davixcky/entrenador-atmega328p/capturas/05-app-diagrama-codigo.png

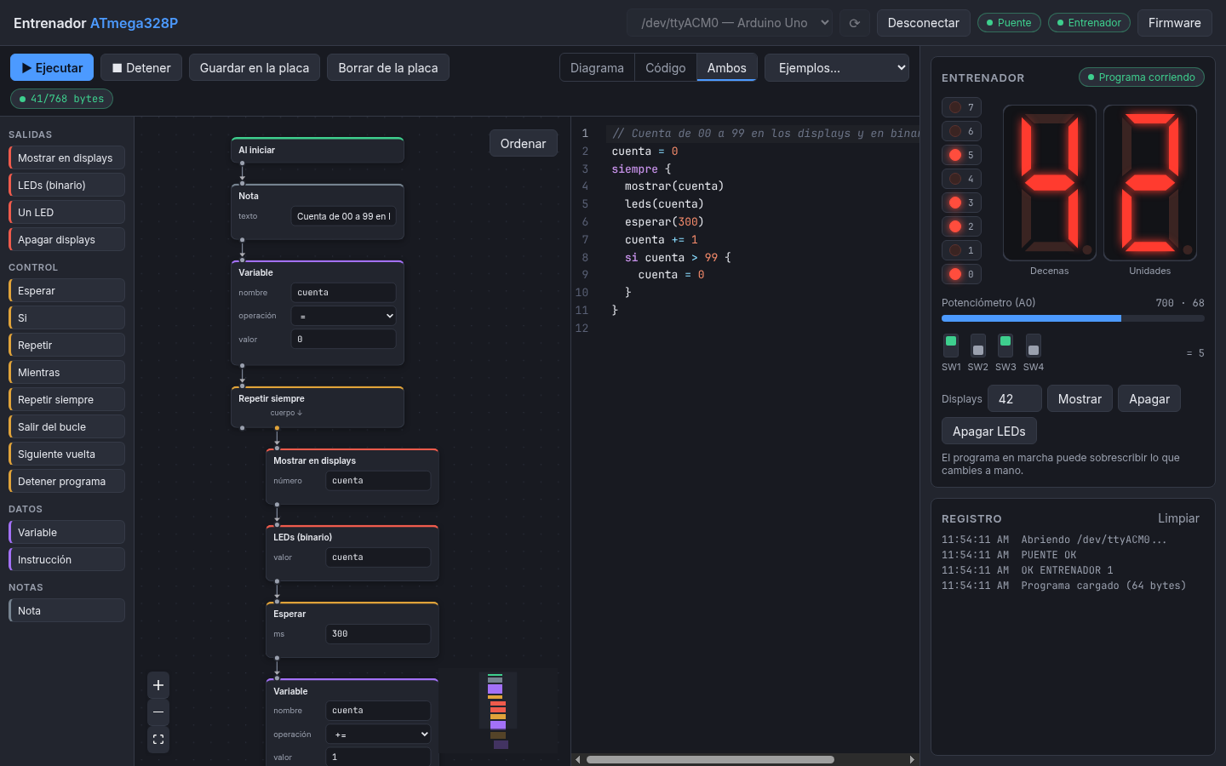
capturas/05-app-diagrama-codigo.png
