davixcky/entrenador-atmega328p/capturas/06-app-monitor-placa.png

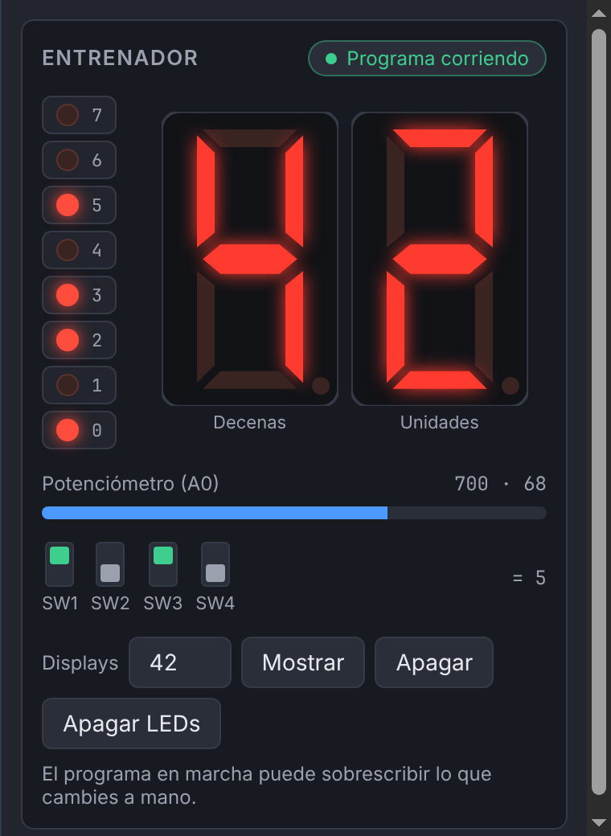
capturas/06-app-monitor-placa.png
