davixcky/entrenador-atmega328p/kicad/fabricacion/render-abajo.png

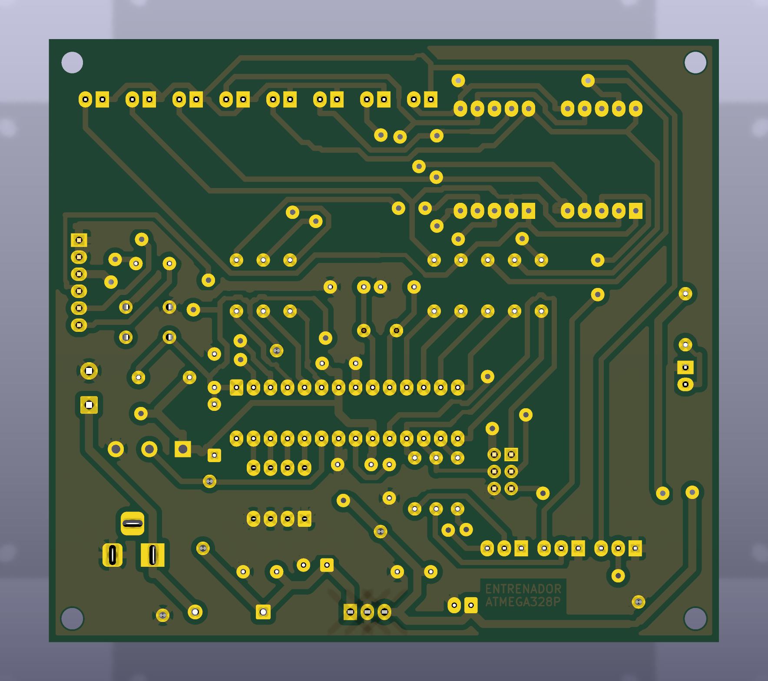
kicad/fabricacion/render-abajo.png
