davixcky/entrenador-atmega328p/kicad/esquematico.pdf

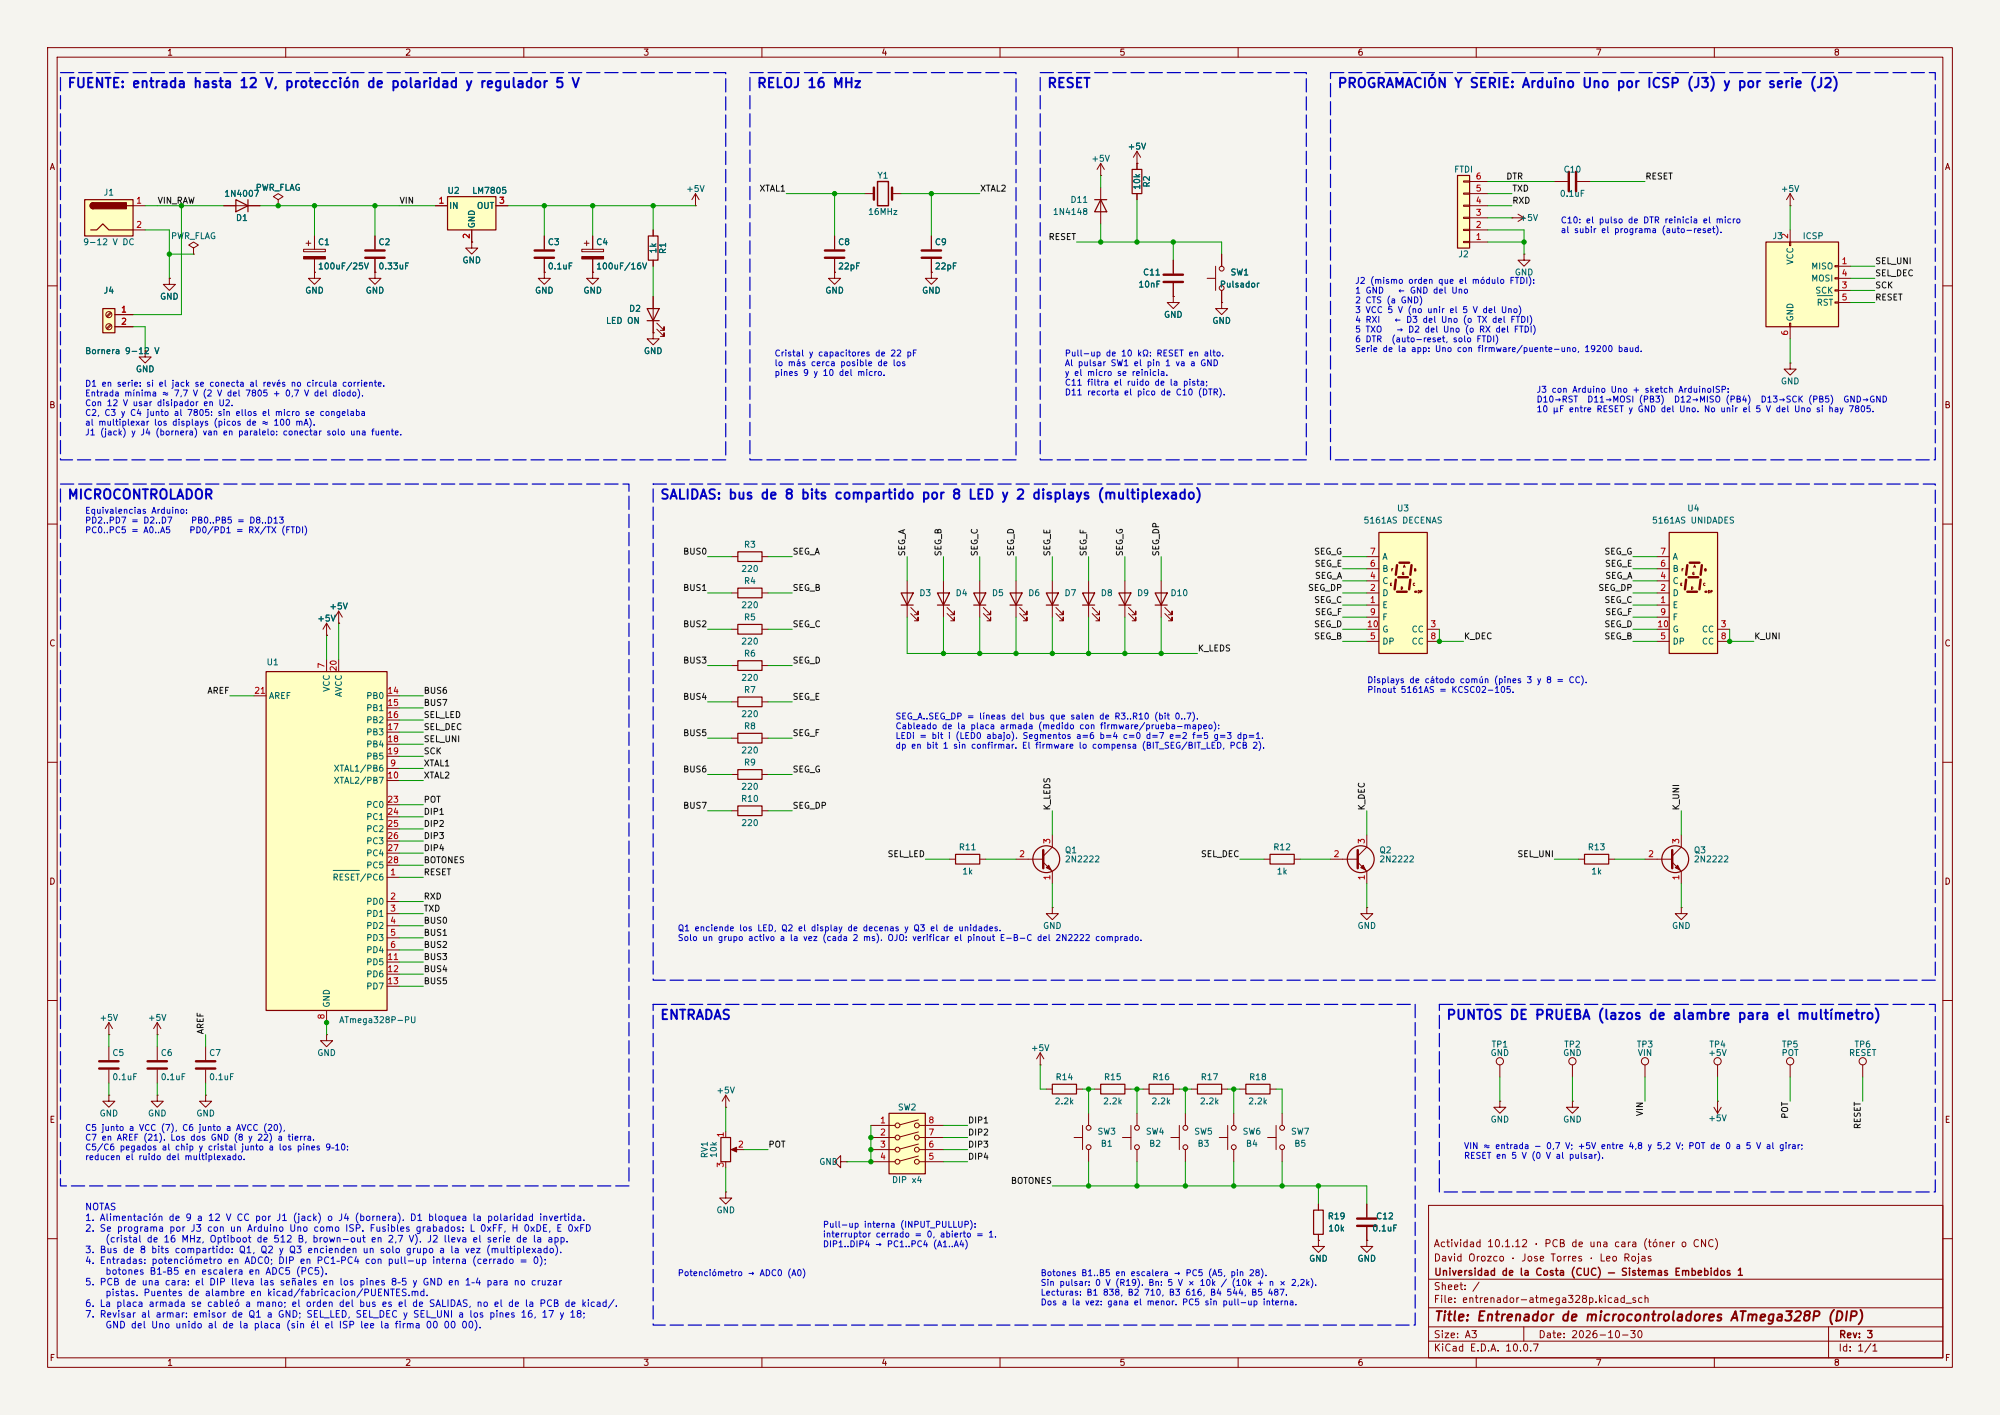
[picture p12: page 1]

FUENTE: entrada hasta 12 V, protección de polaridad y regulador 5 V

C10: el pulso de DTR reinicia el micro
al subir el programa (auto-reset).

y el micro se reinicia. C11 filtra el ruido de la pista; D11 recorta el pico de C10 (DTR). GND

Cristal y capacitores de 22 pF

D1 en serie: si el jack se conecta al revés no circula corriente. Entrada mínima ≈ 7,7 V (2 V del 7805 + 0,7 V del diodo). Con 12 V usar disipador en U2. C2, C3 y C4 junto al 7805: sin ellos el micro se congelaba

10 µF entre RESET y GND del Uno. No unir el 5 V del Uno si hay 7805.

SALIDAS: bus de 8 bits compartido por 8 LED y 2 displays (multiplexado)

Displays de cátodo común (pines 3 y 8 = CC). Pinout 5161AS = KCSC02-105. Q1 enciende los LED, Q2 el display de decenas y Q3 el de unidades. Solo un grupo activo a la vez (cada 2 ms). OJO: verificar el pinout E-B-C del 2N2222 comprado. NOTAS

SEG_A..SEG_DP = líneas del bus que salen de R3..R10 (bit 0..7). Cableado de la placa armada (medido con firmware/prueba-mapeo): LEDi = bit i (LED0 abajo). Segmentos a=6 b=4 c=0 d=7 e=2 f=5 g=3 dp=1.

dp en bit 1 sin confirmar. El firmware lo compensa (BIT_SEG/BIT_LED, PCB 2).

PUNTOS DE PRUEBA (lazos de alambre para el multímetro)

VIN ≈ entrada − 0,7 V; +5V entre 4,8 y 5,2 V; POT de 0 a 5 V al girar; RESET en 5 V (0 V al pulsar).

1. Alimentación de 9 a 12 V CC por J1 (jack) o J4 (bornera). D1 bloquea la polaridad invertida. 2. Se programa por J3 con un Arduino Uno como ISP. Fusibles grabados: L 0xFF, H 0xDE, E 0xFD

(cristal de 16 MHz, Optiboot de 512 B, brown-out en 2,7 V). J2 lleva el serie de la app. 3. Bus de 8 bits compartido: Q1, Q2 y Q3 encienden un solo grupo a la vez (multiplexado).

Actividad 10.1.12 · PCB de una cara (tóner o CNC)
David Orozco · Jose Torres · Leo Rojas
Universidad de la Costa (CUC) — Sistemas Embebidos 1
Sheet: /
File: entrenador-atmega328p.kicad_sch
Title: Entrenador de microcontroladores ATmega328P (DIP)

4. Entradas: potenciómetro en ADC0; DIP en PC1–PC4 con pull-up interna (cerrado = 0); botones B1–B5 en escalera en ADC5 (PC5). 5. PCB de una cara: el DIP lleva las señales en los pines 8–5 y GND en 1–4 para no cruzar pistas. Puentes de alambre en kicad/fabricacion/PUENTES.md. 6. La placa armada se cableó a mano; el orden del bus es el de SALIDAS, no el de la PCB de kicad/. 7. Revisar al armar: emisor de Q1 a GND; SEL_LED, SEL_DEC y SEL_UNI a los pines 16, 17 y 18; GND del Uno unido al de la placa (sin él el ISP lee la firma 00 00 00).

Botones B1..B5 en escalera → PC5 (A5, pin 28). Sin pulsar: 0 V (R19). Bn: 5 V × 10k / (10k + n × 2,2k). Lecturas: B1 838, B2 710, B3 616, B4 544, B5 487. Dos a la vez: gana el menor. PC5 sin pull-up interna.

Size: A3 | Rev: 3 | F Date: 2026-10-30
KiCad E.D.A. 10.0.7 | Id: 1/1
