davixcky/entrenador-atmega328p/kicad/fabricacion/guia-montaje.pdf

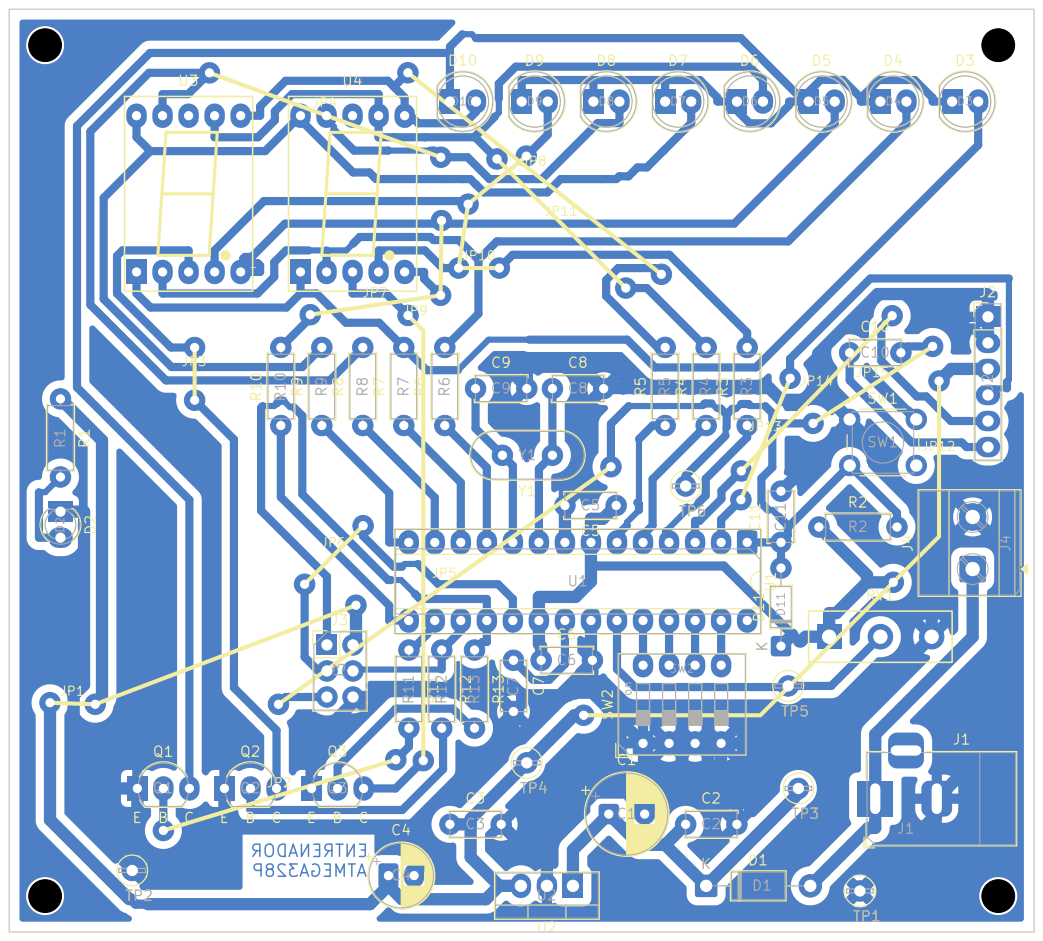
[picture p13: page 1]
