davixcky/entrenador-atmega328p/kicad/fabricacion/vista-cobre-desde-abajo.pdf

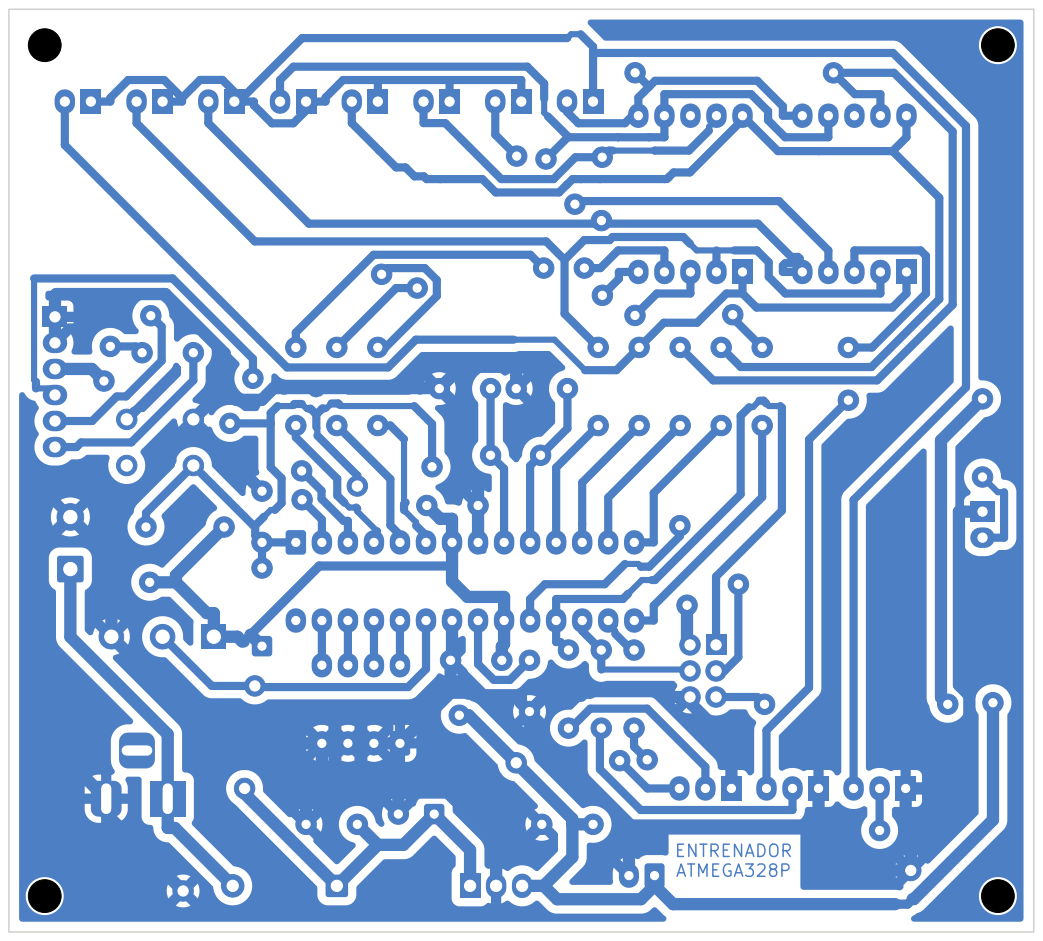
[picture p14: page 1]
