davixcky/entrenador-atmega328p/kicad/fabricacion/toner/1-cobre-B_Cu-1a1.pdf

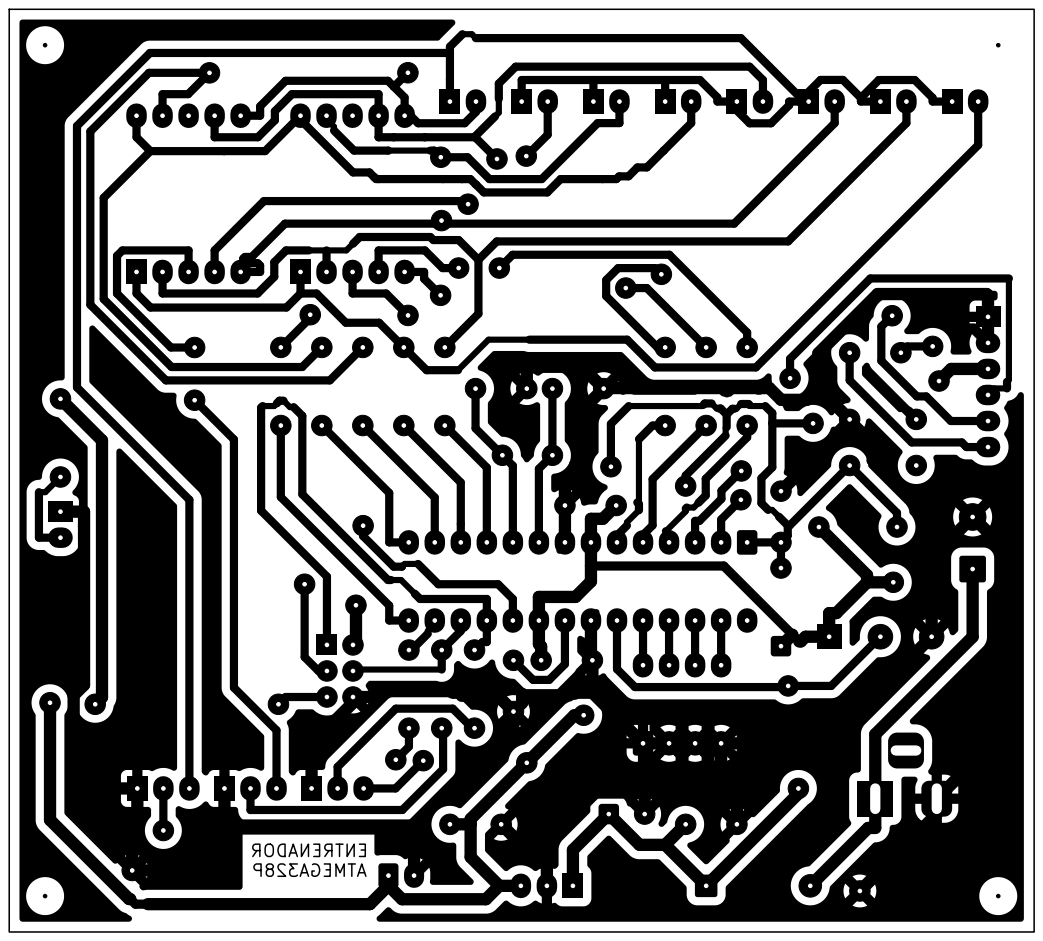
[picture p15: page 1]
