davixcky/entrenador-atmega328p/kicad/fabricacion/toner/2-serigrafia-F_SilkS-espejo-1a1.pdf

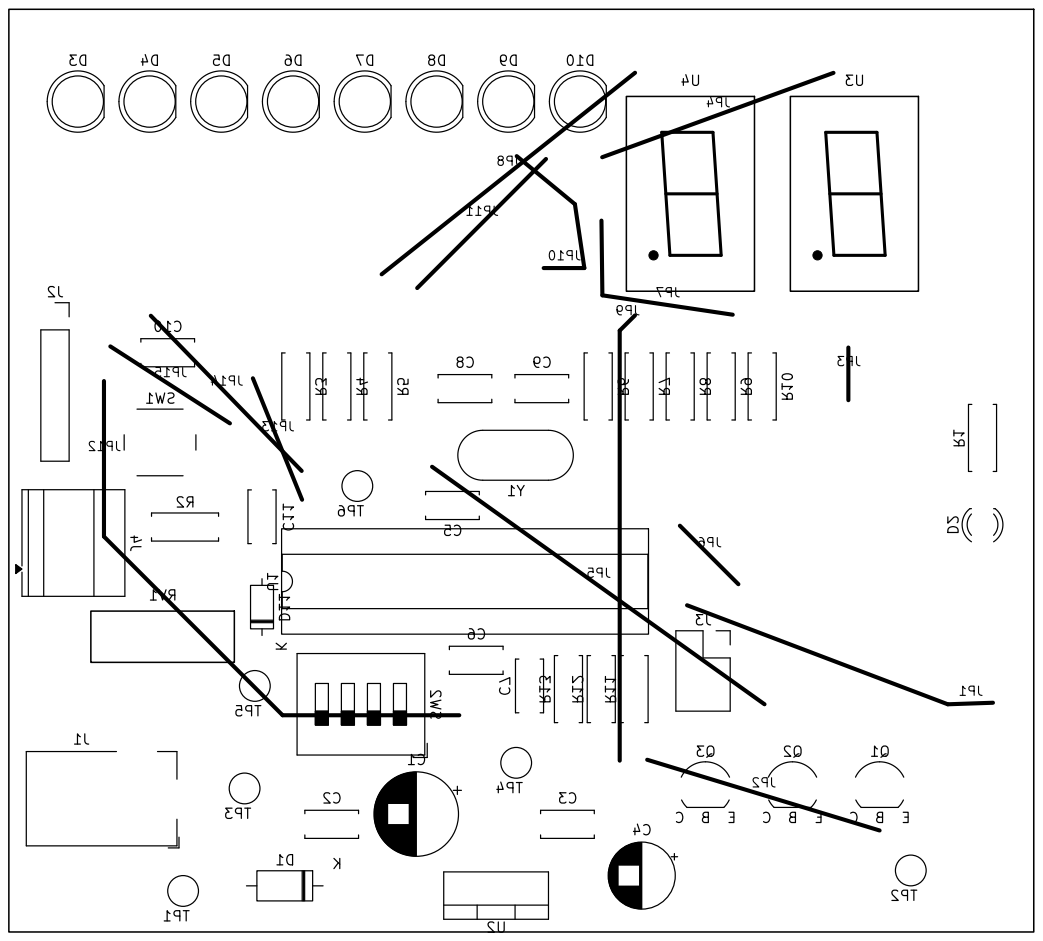
[picture p16: page 1]
