davixcky/entrenador-atmega328p/kicad/entrenador-atmega328p.kicad_pcb

## KiCad design kicad/entrenador-atmega328p.kicad_pcb (2026-10-23)

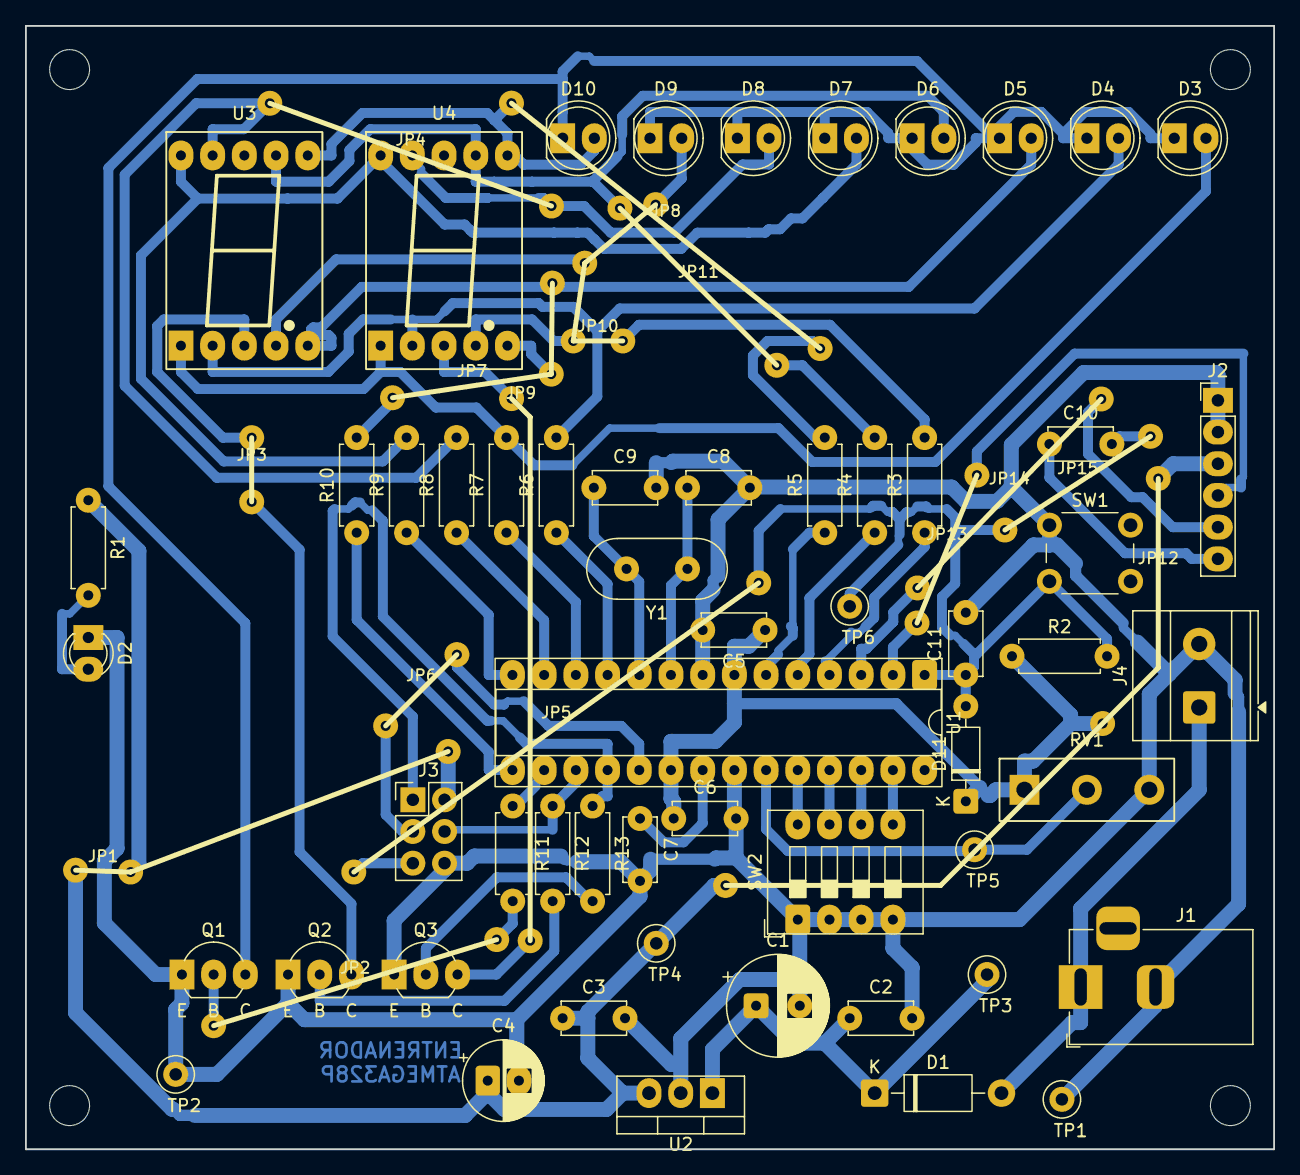
[picture p17: board entrenador-atmega328p.kicad_pcb from above]

Board: 2 copper layers, 100.0 x 90.0 mm, 75 parts (0 on the bottom side), 43 nets.

Parts:
C1: 100uF/25V; CP_Radial_D8.0mm_P3.50mm
C2: 0.33uF; C_Disc_D5.0mm_W2.5mm_P5.00mm
C3, C5, C6, C7, C10: 0.1uF; C_Disc_D5.0mm_W2.5mm_P5.00mm
C4: 100uF/16V; CP_Radial_D6.3mm_P2.50mm
C8, C9: 22pF; C_Disc_D5.0mm_W2.5mm_P5.00mm
C11: 10nF; C_Disc_D5.0mm_W2.5mm_P5.00mm
D1: 1N4007; D_DO-41_SOD81_P10.16mm_Horizontal
D2: LED ON; LED_D3.0mm
D3: LED0; LED_D5.0mm
D4: LED1; LED_D5.0mm
D5: LED2; LED_D5.0mm
D6: LED3; LED_D5.0mm
D7: LED4; LED_D5.0mm
D8: LED5; LED_D5.0mm
D9: LED6; LED_D5.0mm
D10: LED7; LED_D5.0mm
D11: 1N4148; D_DO-35_SOD27_P7.62mm_Horizontal
H1, H2, H3, H4: MountingHole_3.2mm_M3
J1: 9-12 V DC; BarrelJack_Horizontal
J2: FTDI; PinHeader_1x06_P2.54mm_Vertical
J3: ICSP; PinHeader_2x03_P2.54mm_Vertical
J4: Bornera 9-12 V; TerminalBlock_Phoenix_MKDS-1,5-2-5.08_1x02_P5.08mm_Horizont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
JP1, JP2, JP3, JP4, JP5, JP6, JP7, JP8, JP9, JP10, JP11, JP12, JP13, JP14, JP15: puente; Puente_alambre
Q1, Q2, Q3: 2N2222; TO-92_Inline_Wide
R1, R11, R12, R13: 1k; R_Axial_DIN0207_L6.3mm_D2.5mm_P7.62mm_Horizontal
R2: 10k; R_Axial_DIN0207_L6.3mm_D2.5mm_P7.62mm_Horizontal
R3, R4, R5, R6, R7, R8, R9, R10: 220; R_Axial_DIN0207_L6.3mm_D2.5mm_P7.62mm_Horizontal
RV1: 10k; Pot_3pin_P5.00mm
SW1: Pulsador; SW_PUSH_6mm
SW2: DIP x4; SW_DIP_SPSTx04_Slide_9.78x12.34mm_W7.62mm_P2.54mm
TP1, TP2: GND; TestPoint_Loop_D2.50mm_Drill1.0mm
TP3: VIN; TestPoint_Loop_D2.50mm_Drill1.0mm
TP4: +5V; TestPoint_Loop_D2.50mm_Drill1.0mm
TP5: POT; TestPoint_Loop_D2.50mm_Drill1.0mm
TP6: RESET; TestPoint_Loop_D2.50mm_Drill1.0mm
U1: ATmega328P-PU; DIP-28_W7.62mm_Socket
U2: LM7805; TO-220-3_Vertical
U3: 5161AS DECENAS; Display_5161AS
U4: 5161AS UNIDADES; Display_5161AS
Y1: 16MHz; Crystal_HC49-4H_Vertical

Connections:
+5V: C3.1, C4.1, C5.1, C6.1, D11.1, J2.3, J3.2, JP1.1, JP12.1, R1.1, R2.1, RV1.1, TP4.1, U1.7, U1.20, U2.3
/AREF: C7.1, U1.21
/BUS0: R3.1, U1.4
/BUS1: R4.1, U1.5
/BUS2: R5.1, U1.6
/BUS3: R6.1, U1.11
/BUS4: R7.1, U1.12
/BUS5: R8.1, U1.13
/BUS6: R9.1, U1.14
/BUS7: R10.1, U1.15
/DIP1: SW2.8, U1.24
/DIP2: SW2.7, U1.25
/DIP3: SW2.6, U1.26
/DIP4: SW2.5, U1.27
/DTR: C10.1, J2.6
/K_DEC: JP3.1, Q2.3, U3.3, U3.8
/K_LEDS: D3.1, D4.1, D5.1, D6.1, D7.1, D8.1, D9.1, D10.1, Q1.3
/K_UNI: JP9.1, Q3.3, U4.3, U4.8
/POT: RV1.2, TP5.1, U1.23
/RESET: C10.2, C11.1, D11.2, J3.5, JP5.1, JP15.1, R2.2, SW1.2, TP6.1, U1.1
/RXD: J2.4, JP13.1, U1.2
/SCK: J3.3, JP6.1, U1.19
/SEG_A: D9.2, JP10.1, R3.2, U3.4, U4.4
/SEG_B: D6.2, JP11.1, R4.2, U3.7, U4.7
/SEG_C: D10.2, JP8.1, R5.2, U3.6, U4.6
/SEG_D: D4.2, R6.2, U3.2, U4.2
/SEG_DP: D5.2, JP7.1, R10.2, U3.5, U4.5
/SEG_E: D3.2, R7.2, U3.1, U4.1
/SEG_F: D8.2, JP4.1, R8.2, U3.9, U4.9
/SEG_G: D7.2, R9.2, U3.10, U4.10
/SEL_DEC: J3.4, R12.1, U1.17
/SEL_LED: R11.1, U1.16
/SEL_UNI: J3.1, R13.1, U1.18
/TXD: J2.5, JP14.1, U1.3
/VIN: C1.1, C2.1, D1.1, TP3.1, U2.1
/VIN_RAW: D1.2, J1.1, J4.1
/XTAL1: C8.1, U1.9, Y1.1
/XTAL2: C9.1, U1.10, Y1.2
GND: C1.2, C2.2, C3.2, C4.2, C5.2, C6.2, C7.2, C8.2, C9.2, C11.2, D2.1, J1.2, J2.1, J2.2, J3.6, J4.2, Q1.1, Q2.1, Q3.1, RV1.3, SW1.1, SW2.1, SW2.2, SW2.3, SW2.4, TP1.1, TP2.1, U1.8, U1.22, U2.2
unnamed: D2.2, R1.2
unnamed: JP2.1, Q1.2, R11.2
unnamed: Q2.2, R12.2
unnamed: Q3.2, R13.2
