davixcky/entrenador-atmega328p/(commit log)

2026-10-16 Entrenador ATMega328P: esquematico KiCad, firmware, pruebas y avance
    - Esquematico en KiCad 10 (ERC sin errores) generado y verificado por script
    - Lista de conexiones pin a pin (CONEXIONES.md/pdf)
    - Firmware: ArduinoISP, pruebas (blink, estatica, displays) y entrenador
    - Programacion con Arduino Uno como ISP: bootloader y fusibles a 16 MHz
    - Pruebas en protoboard con capturas y problemas encontrados
    - README con el avance y su version en PDF
    [entrenador-atmega328p.kicad_sch]
2026-10-23 Completar PCB, firmware y presentación final del entrenador
    [entrenador-atmega328p.kicad_pcb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]
2026-10-23 Dejar abiertos los nombres y roles de la presentación
2026-10-23 Simplificar README y separar el registro técnico
2026-10-31 Agregar app de programación, lenguaje y biblioteca Entrenador
    - app/: app de escritorio (Wails) con diagrama de nodos y código, monitor en vivo,
    vista del código generado (sketch de Arduino y bytecode) y grabación con avrdude.
    - app/lenguaje/: lenguaje del entrenador (analizador, compilador a bytecode,
    generador de sketches de Arduino, desensamblador) con pruebas.
    - firmware/bloques: máquina virtual que recibe programas por serie.
    - firmware/puente-uno: ArduinoISP más puente serie hacia el entrenador.
    - firmware/libraries/Entrenador: hardware compartido (multiplexado, bus, entradas).
    - Sketches de prueba del mapeo, el potenciómetro y las salidas.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
2026-10-31 Actualizar esquemático a la placa armada y agregar botones en escalera
    Mapeo real del bus, serie con el Uno por J2, notas de armado y botones B1..B5
    en escalera en PC5. Regenerado con KiCad 10: ERC sin errores y netlist verificado.
    [entrenador-atmega328p.kicad_sch]
2026-10-31 Agregar guía de uso en español e inglés y README en inglés
